Papamaker/kitco/applis/src/spaceinvaders/space-invader-partie.jpg

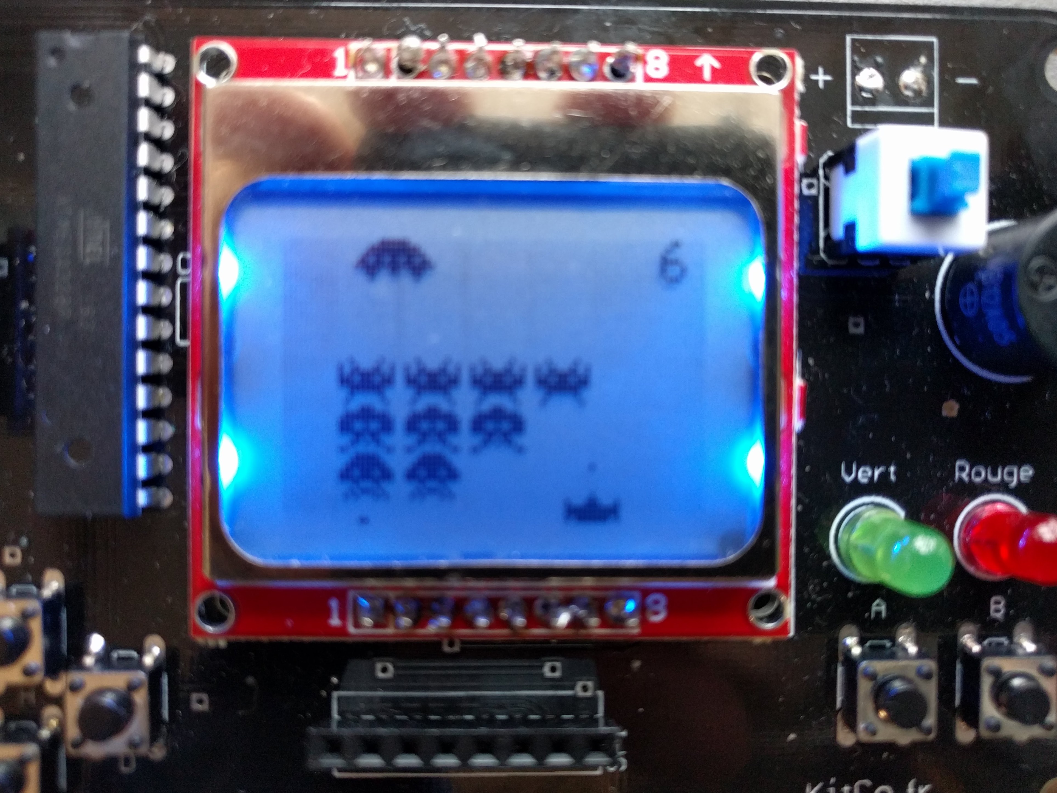
applis/src/spaceinvaders/space-invader-partie.jpg
