Papamaker/kitco/boitiers 3D/laser/IMG_20170427_201355-01.jpeg

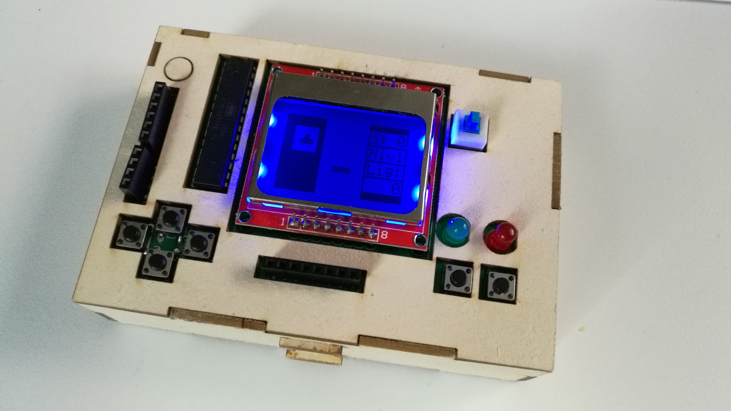
boitiers 3D/laser/IMG_20170427_201355-01.jpeg
