Papamaker/kitco/README.md

# La console Kitco

Auteur: François Jacob

Ceci est le projet de la console Kitco. Le but de ce projet est de fournir un kit de console portable pour un coût réduit en matériel.

Rendez-vous sur www.kitco.fr
