Papamaker/kitco/ManuelKitco.pdf

1

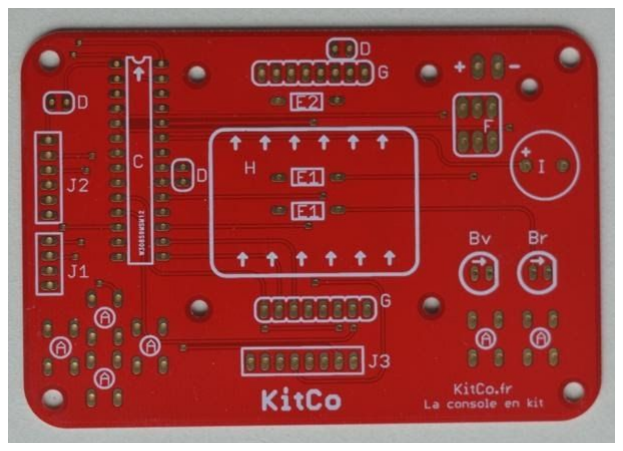
[picture p3: figure]

Circuit imprimé
(PCB : Printed Circuit Board)

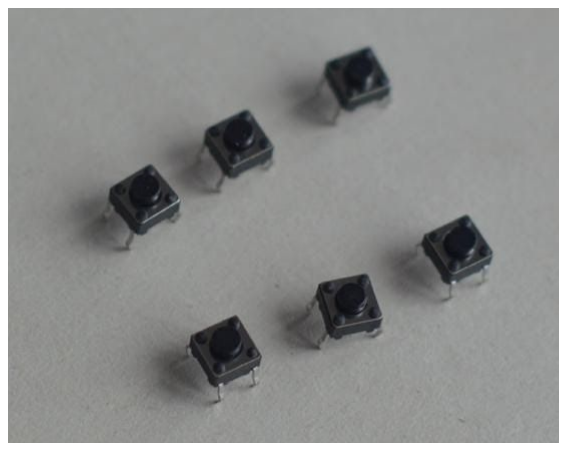
[picture p4: figure]

6 Boutons poussoirs

Positionner (on peut les « clipser ») puis souder les 6 boutons poussoirs sur le circuit imprimé aux endroits marqués « A ».

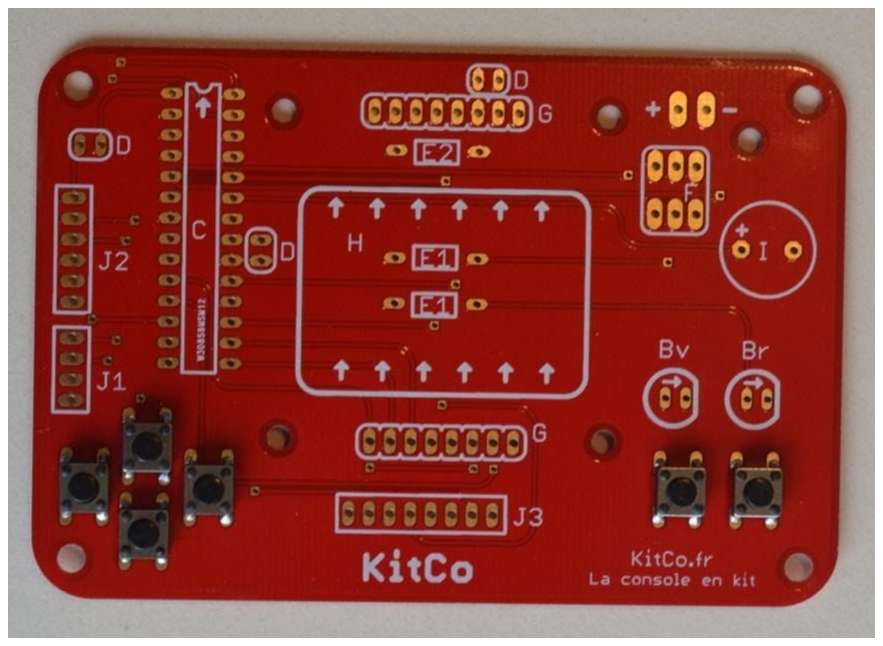
[picture p5: figure]

2

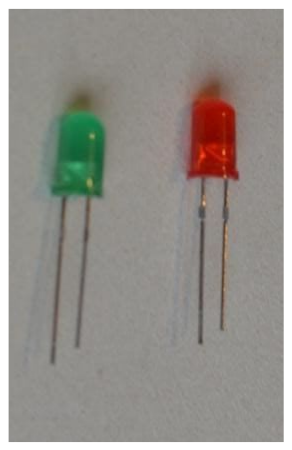
[picture p6: figure]

Diodes électroluminescentes
(LED : Light Emitting Diode)

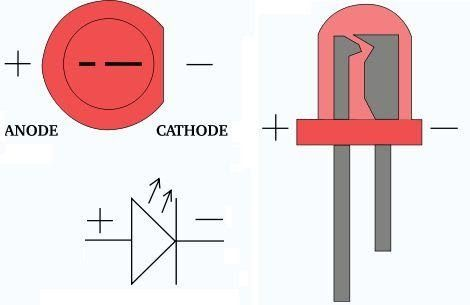
[picture p7: figure]

Positionner les 2 diodes (on peut s’aider de ruban adhésif) puis les souder sur le circuit imprimé aux endroits marqués « Bv » et « Br ».

Respecter la polarité : la patte la plus courte
(et le méplat) vers la droite de la console.

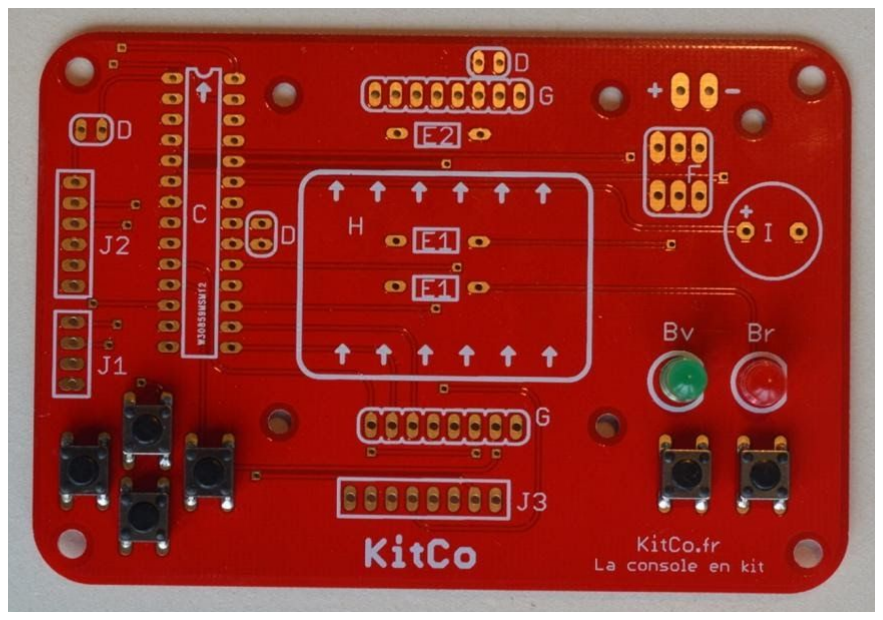
[picture p8: figure]

3

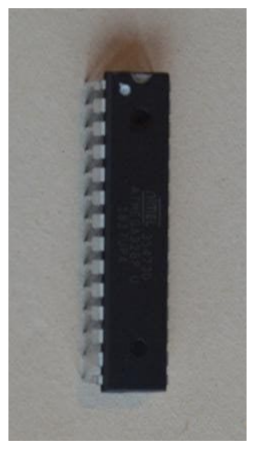
[picture p9: figure]

Microcontrôleur
(Toute « l’intelligence » :
mémoire, mesures, actions)

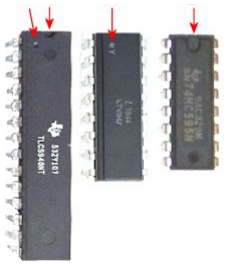
[picture p10: figure]
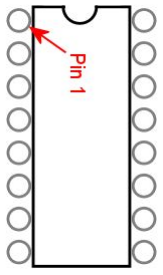
[picture p11: figure]

Souder le microcontrôleur sur le circuit imprimé à l’endroit marqué « C ».

Respecter l’orientation : le méplat vers le haut de la console.

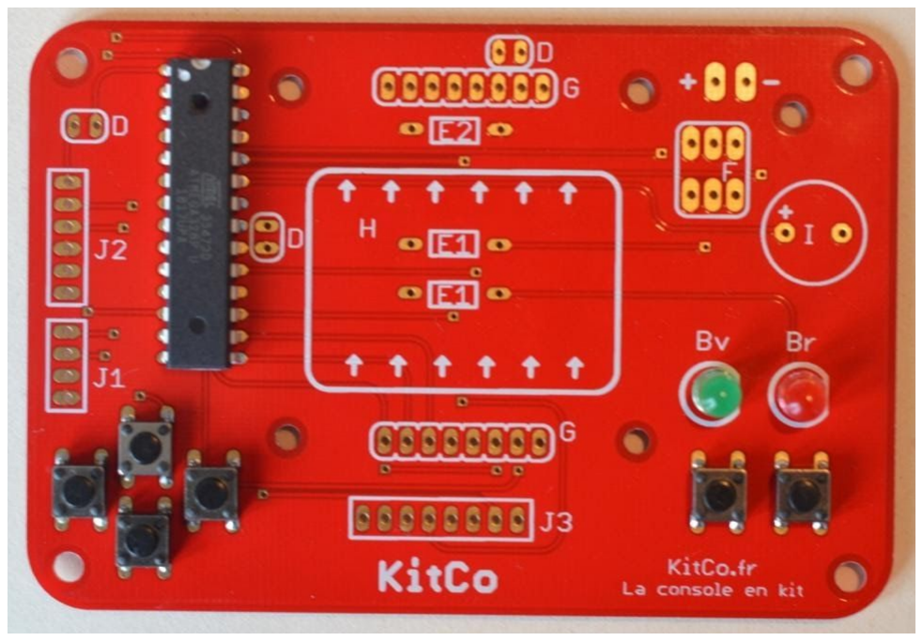
[picture p12: figure]

4

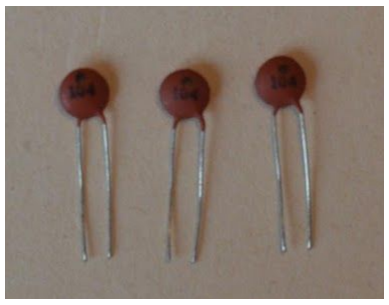
[picture p13: figure]

Condensateurs
(« mini piles rechargeables » : rapide mais peu de capacité)

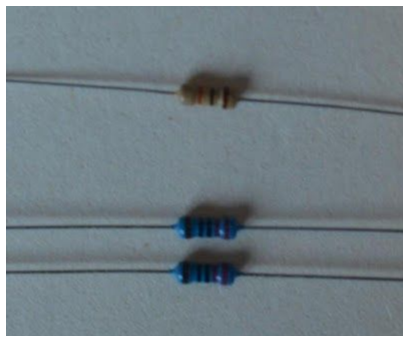
[picture p14: figure]

1 résistance de 10k Ω (Ohm) 2 résistances de 220 Ω
(Pour limiter le courant : afin que la diode ne brûle pas)

Souder les 3 condensateurs (on peut s’aider de ruban adhésif) sur le circuit imprimé aux endroits marqués « D ».
Souder les résistances de 220 Ω | en « E1 ».
Souder la résistance de 10k Ω | en « E2 ».

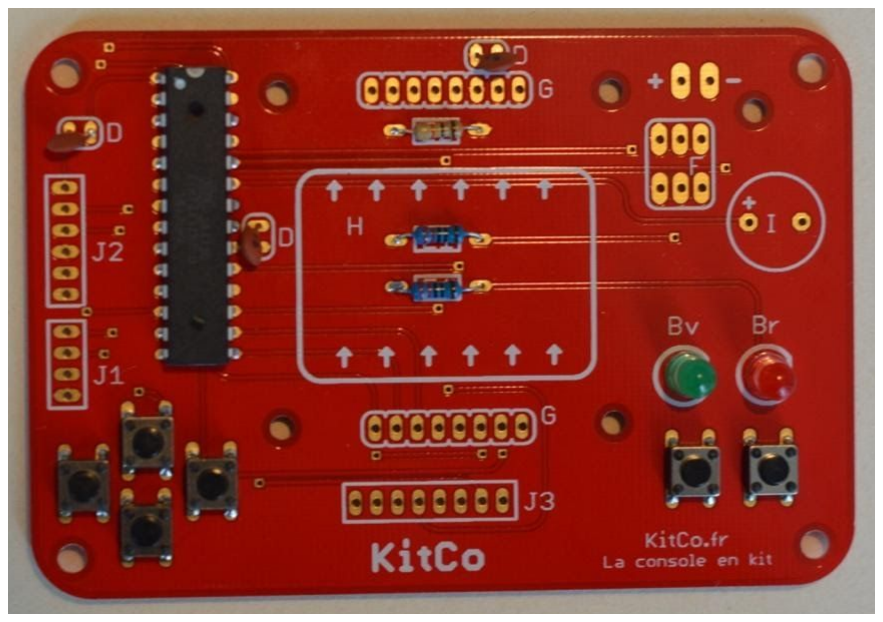
[picture p15: figure]

5

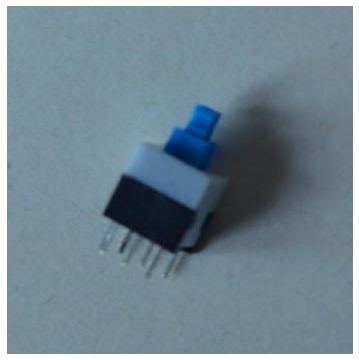
[picture p16: figure]

Interrupteur

Souder l’interrupteur en « F ».

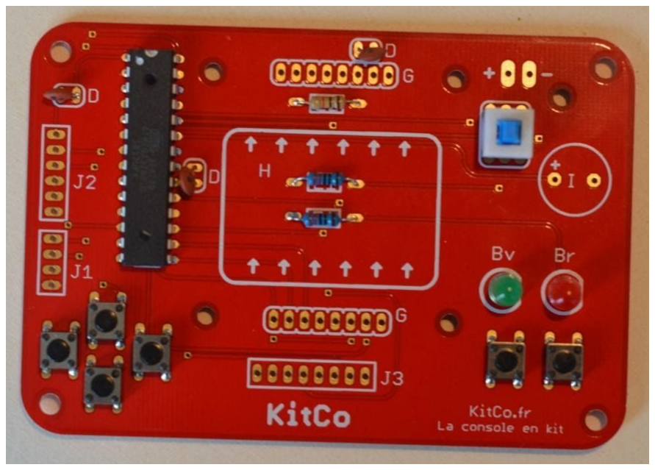
[picture p17: figure]

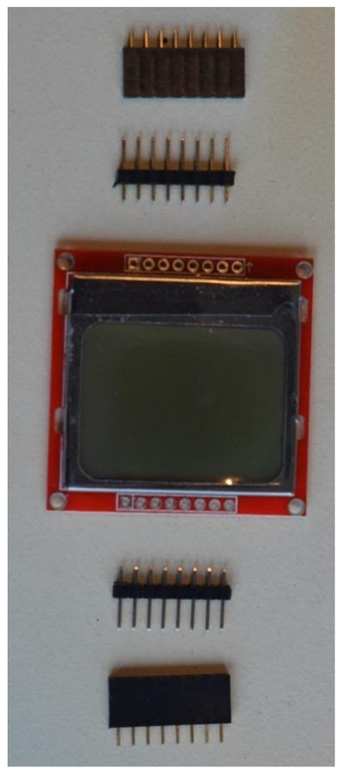
[picture p18: figure]
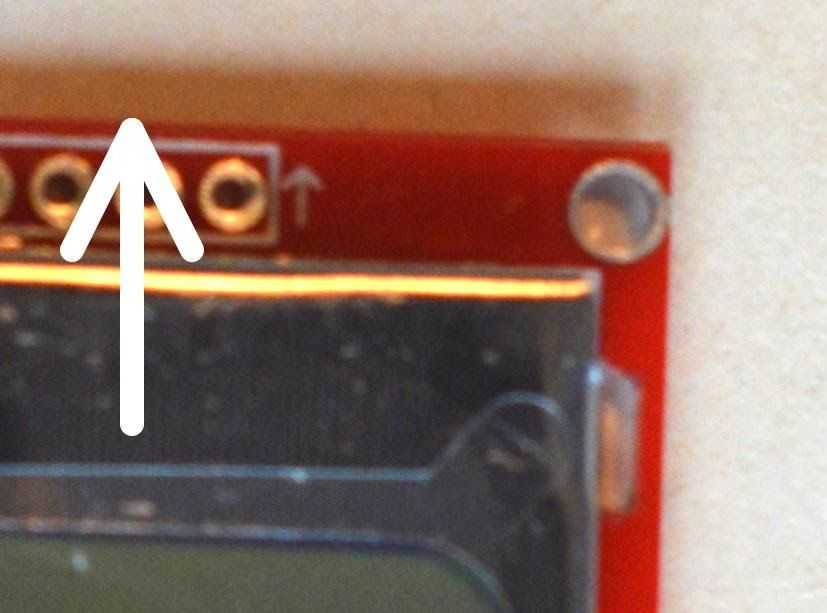
[picture p19: figure]

Assemblage de l’écran
(LCD : Liquid Cristal Display)
6

Assembler 2 paires de connecteurs les insérer en « G », ajouter l’écran. Fixer l’ensemble avec un ruban adhésif avant de souder les deux faces.

Respecter l’orientation : la flèche (et la partie métallique la plus large de l’écran) vers le haut de la console.

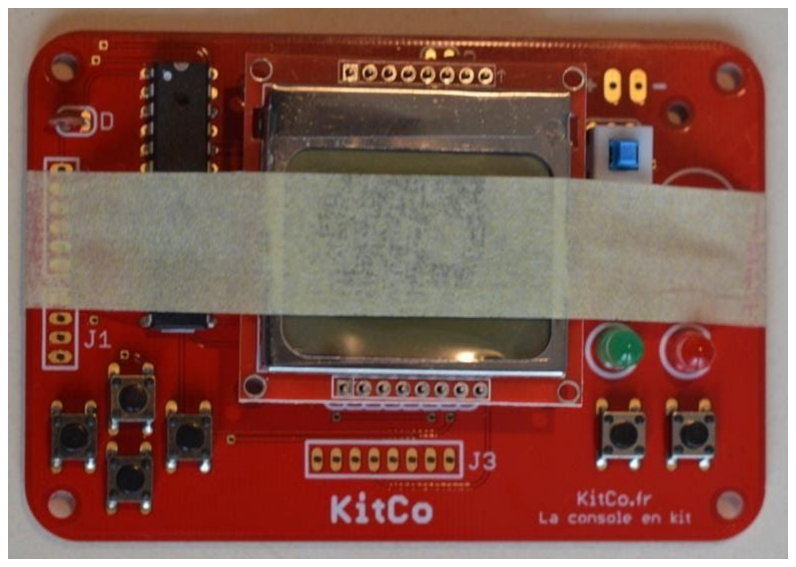
[picture p20: figure]

7

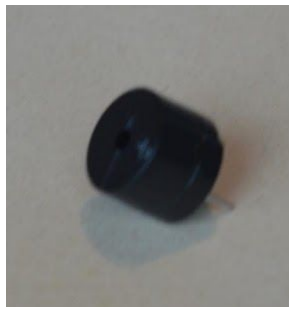
[picture p21: figure]

Buzzer
(Haut-parleur)

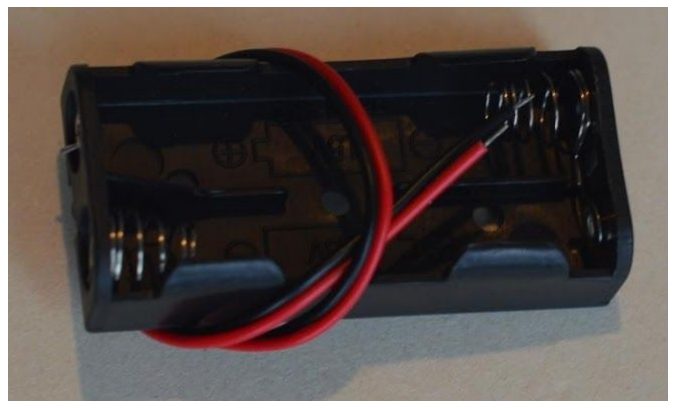
[picture p22: figure]

Boitier piles

Souder le buzzer en « I ».
Respecter la polarité : le « + » vers la gauche de la console.
Passer le câble du boitier piles dans le trou, le nouer puis le souder en « J » (dos de console). Respecter la polarité : le rouge avec le « + », le noir avec le « - ».

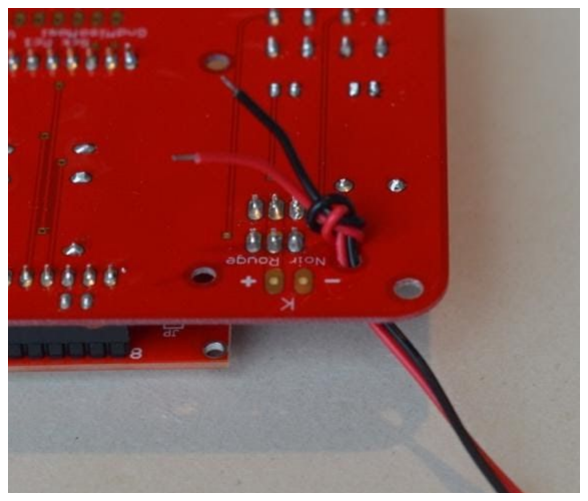
[picture p23: figure]

Il est recommandé de passer le câble dans l’autre sens : nœud sur la face avant de la console.

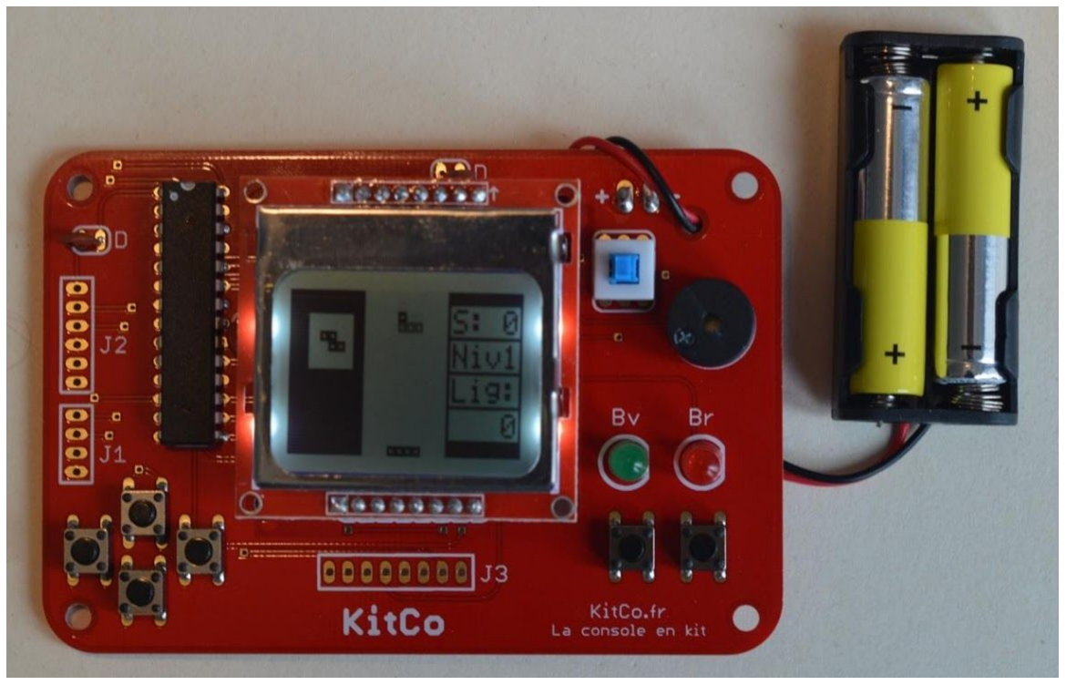
[picture p24: figure]

La KitCo est une console open source conçue pour initier à l’électronique. Les participants pourront en modifier le logiciel après l’atelier à l’aide du logiciel Arduino.
Pour plus d’informations : www.kitco.fr

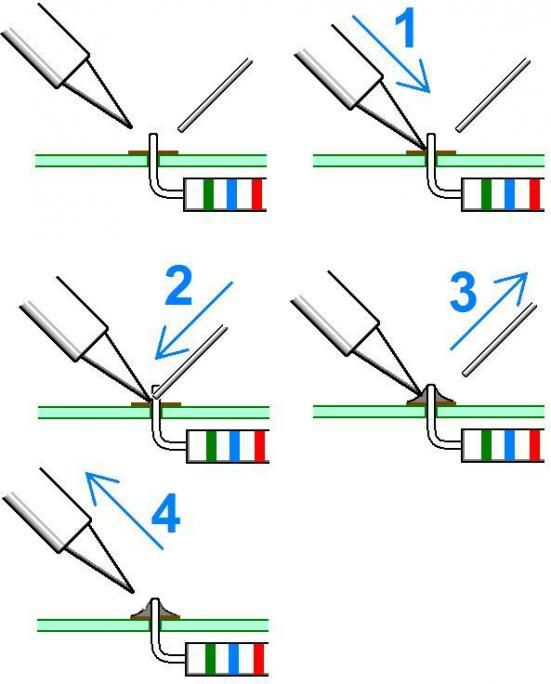
[picture p25: figure]
