Papamaker/kitco/boitiers/carton/readme.md

Version beta: la nouvelle boite n'est pas encore disponible officiellement. Trouvez ici toutes les ressources pour utiliser la nouvelle boite comme boîter pour Kitco!
