Papamaker/kitco/applis/src/readme.md

Les applis suivantes:

- cassebriques
- pacrob 
- snake 

nécessitent les deux librairies adafruit suivantes :
- https://github.com/adafruit/Adafruit-GFX-Library
- https://github.com/adafruit/Adafruit-PCD8544-Nokia-5110-LCD-library
