Papamaker/kitco/applis/src/spaceinvaders/readme.md

Il s'agit d'un jeu codé par Eric Lefevre. Vous pouvez retrouver la dernière version du jeu à cet endroit:

https://github.com/elefevre/jeux-kitco/
