Papamaker/kitco/applis/src/pacrob/README.txt

Ceci est un programme pour apprendre la programmation à des enfants

Le but du jeu est de permettre à pac-rob de sortir du labyrinthe en lui envoyant un programme informatique! 

C'est donc une sorte de pacman mais qui est commandé par un programme au lieu d'être programmé en direct. L'utilisateur spécifie le programme et ensuite le "pac-rob" va éxécuter les instructions et se déplacer en conséquence!

Le but du jeu est de permettre à pac-rob de sortir de différents niveaux intact

Cette application nécessite la bibliothèque adafruit disponible ici:

https://github.com/adafruit/Adafruit-PCD8544-Nokia-5110-LCD-library
