Papamaker/kitco/boitiers/carton/kitco + étiquette.pdf

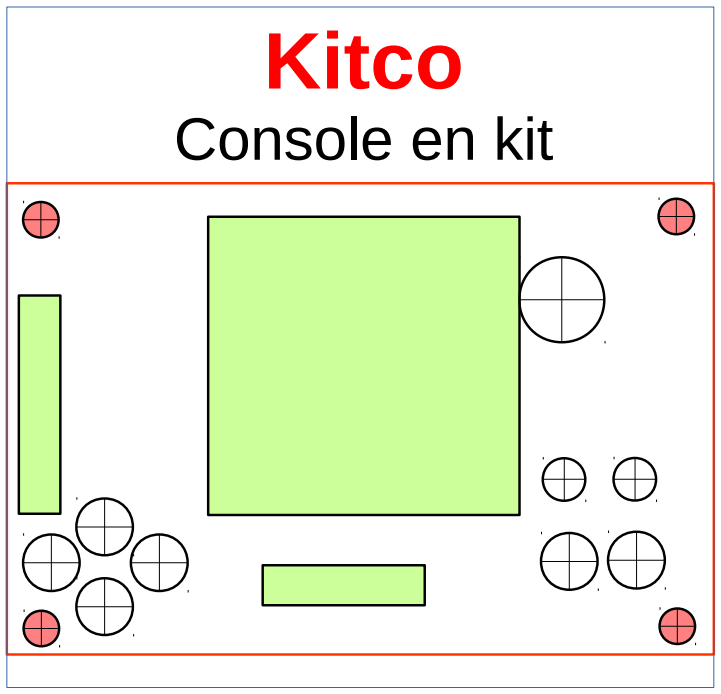
[picture p26: figure]
Kitco Console en kit
