Papamaker/kitco/schemaKitco.png

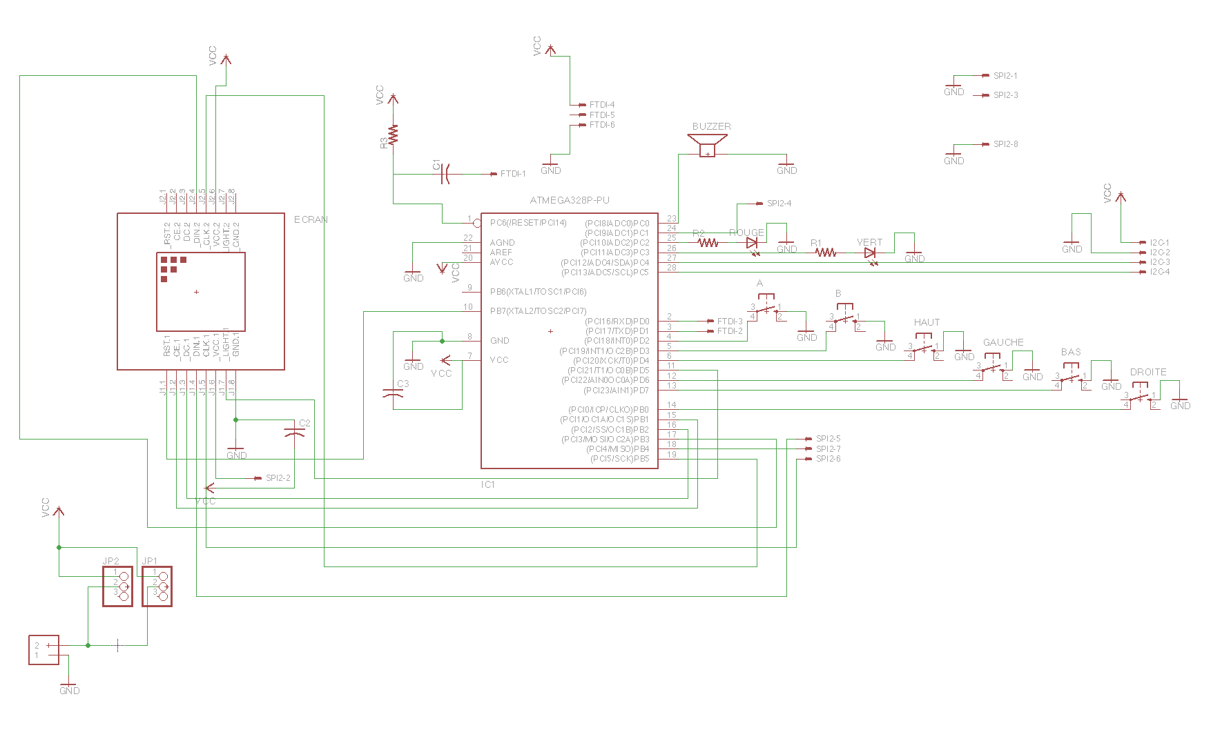
schemaKitco.png
