Papamaker/kitco/boitiers 3D/basic.o/basic_o.stl

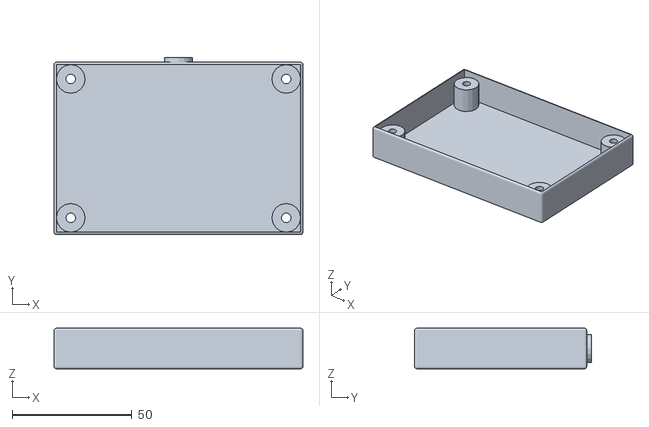
[picture p28: CAD file, 2016-10-02]
boitiers 3D/basic.o/basic_o.stl
104.0 x 74.0 x 17.0
