Papamaker/kitco/boitiers 3D/laser/Kitco01-20170427.stl

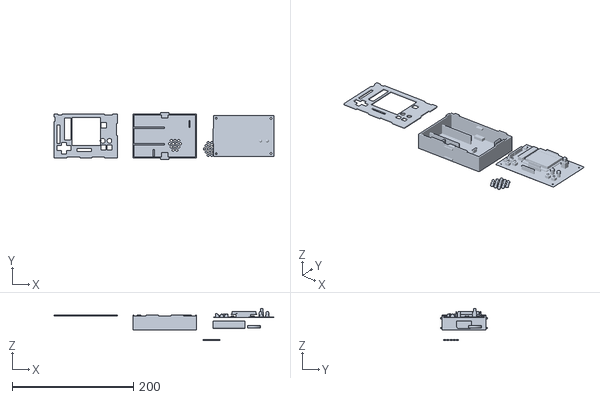
[picture p29: CAD file, 2017-05-20]
boitiers 3D/laser/Kitco01-20170427.stl
362.5 x 77.0 x 53.3
