Papamaker/kitco/(list of files, cad)

Other CAD files:
boitiers 3D/laser/Kitco01-20170427.skp
