Papamaker/kitco/eagle/kitco5.brd

## EAGLE design eagle/kitco5.brd (2017-11-03)

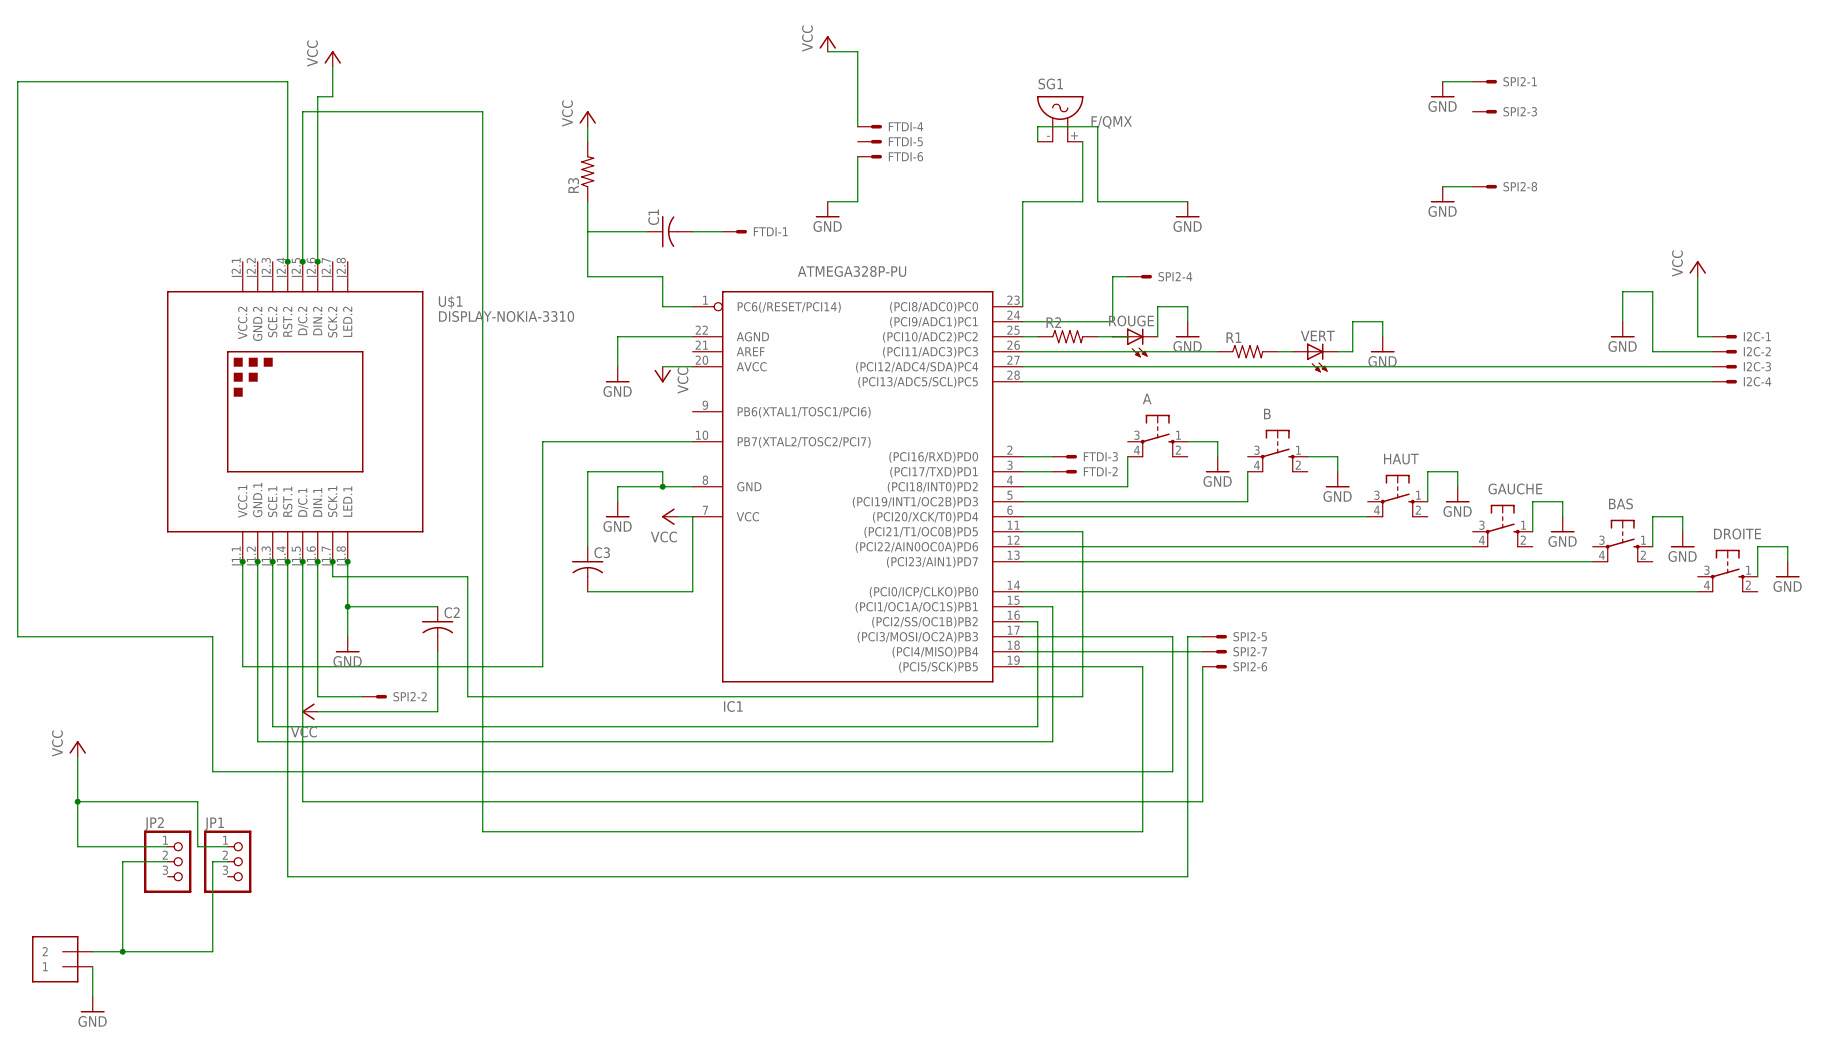
[picture p30: schematic kitco5.sch]

Parts:
A: 10-XX; B3F-10XX
B: 10-XX; B3F-10XX
BAS: 10-XX; B3F-10XX
C1, C2, C3: C-US025-040X050; C025-040X050
DROITE: 10-XX; B3F-10XX
FTDI: 22-23-2061
GAUCHE: 10-XX; B3F-10XX
HAUT: 10-XX; B3F-10XX
I2C: 22-23-2041
IC1: ATMEGA328P-PU; DIL28-3
J1: 1X2-3.5MM
JP1, JP2: PINHD-1X3; 1X03
R1, R2, R3: R-US_0207/10; 0207/10
ROUGE: LED5MM
SG1: F/QMX
SPI2: 22-23-2081
U$1: DISPLAY-NOKIA-3310
VERT: LED5MM

Connections:
GND: A.1 (S), B.1 (S), BAS.1 (S), C2.1, C3.1, DROITE.1 (S), FTDI.6, GAUCHE.1 (S), HAUT.1 (S), I2C.2, IC1.8 (GND), IC1.22 (AGND), J1.1, ROUGE.K (C), SG1.- (1), SPI2.1, SPI2.8, U$1.J1.8 (LED.1), VERT.K (C)
GND.2: U$1.J2.2 (GND.2)
unnamed: A.4 (P1), IC1.4 ((PCI18/INT0)PD2)
unnamed: B.4 (P1), IC1.5 ((PCI19/INT1/OC2B)PD3)
unnamed: IC1.11 ((PCI21/T1/OC0B)PD5), U$1.J1.7 (SCK.1)
unnamed: GAUCHE.4 (P1), IC1.12 ((PCI22/AIN0OC0A)PD6)
unnamed: BAS.4 (P1), IC1.13 ((PCI23/AIN1)PD7)
unnamed: DROITE.4 (P1), IC1.14 ((PCI0/ICP/CLKO)PB0)
unnamed: I2C.3, IC1.27 ((PCI12/ADC4/SDA)PC4)
unnamed: I2C.4, IC1.28 ((PCI13/ADC5/SCL)PC5)
unnamed: J1.2, JP1.2, JP2.2
unnamed: HAUT.4 (P1), IC1.6 ((PCI20/XCK/T0)PD4)
unnamed: FTDI.2, IC1.3 ((PCI17/TXD)PD1)
unnamed: IC1.26 ((PCI11/ADC3)PC3), R1.1
unnamed: R1.2, VERT.A
unnamed: IC1.25 ((PCI10/ADC2)PC2), R2.1
unnamed: R2.2, ROUGE.A
unnamed: IC1.24 ((PCI9/ADC1)PC1), SPI2.4
unnamed: IC1.17 ((PCI3/MOSI/OC2A)PB3), U$1.J2.4 (RST.2)
unnamed: IC1.19 ((PCI5/SCK)PB5), U$1.J2.5 (D/C.2)
unnamed: IC1.15 ((PCI1/OC1A/OC1S)PB1), U$1.J1.2 (GND.1)
unnamed: IC1.16 ((PCI2/SS/OC1B)PB2), U$1.J1.3 (SCE.1)
unnamed: FTDI.3, IC1.2 ((PCI16/RXD)PD0)
unnamed: IC1.18 ((PCI4/MISO)PB4), SPI2.7
unnamed: IC1.23 ((PCI8/ADC0)PC0), SG1.+ (2)
unnamed: SPI2.5, U$1.J1.4 (RST.1)
unnamed: C1.2, FTDI.1
unnamed: SPI2.6, U$1.J1.5 (D/C.1)
unnamed: SPI2.2, U$1.J1.6 (DIN.1)
unnamed: C1.1, IC1.1 (PC6(/RESET/PCI14)), R3.1
unnamed: IC1.10 (PB7(XTAL2/TOSC2/PCI7)), U$1.J1.1 (VCC.1)
VCC: C2.2, C3.2, FTDI.4, I2C.1, IC1.7 (VCC), IC1.20 (AVCC), JP1.1, JP2.1, R3.2, U$1.J2.6 (DIN.2)
VCC.2: U$1.J2.1 (VCC.2)

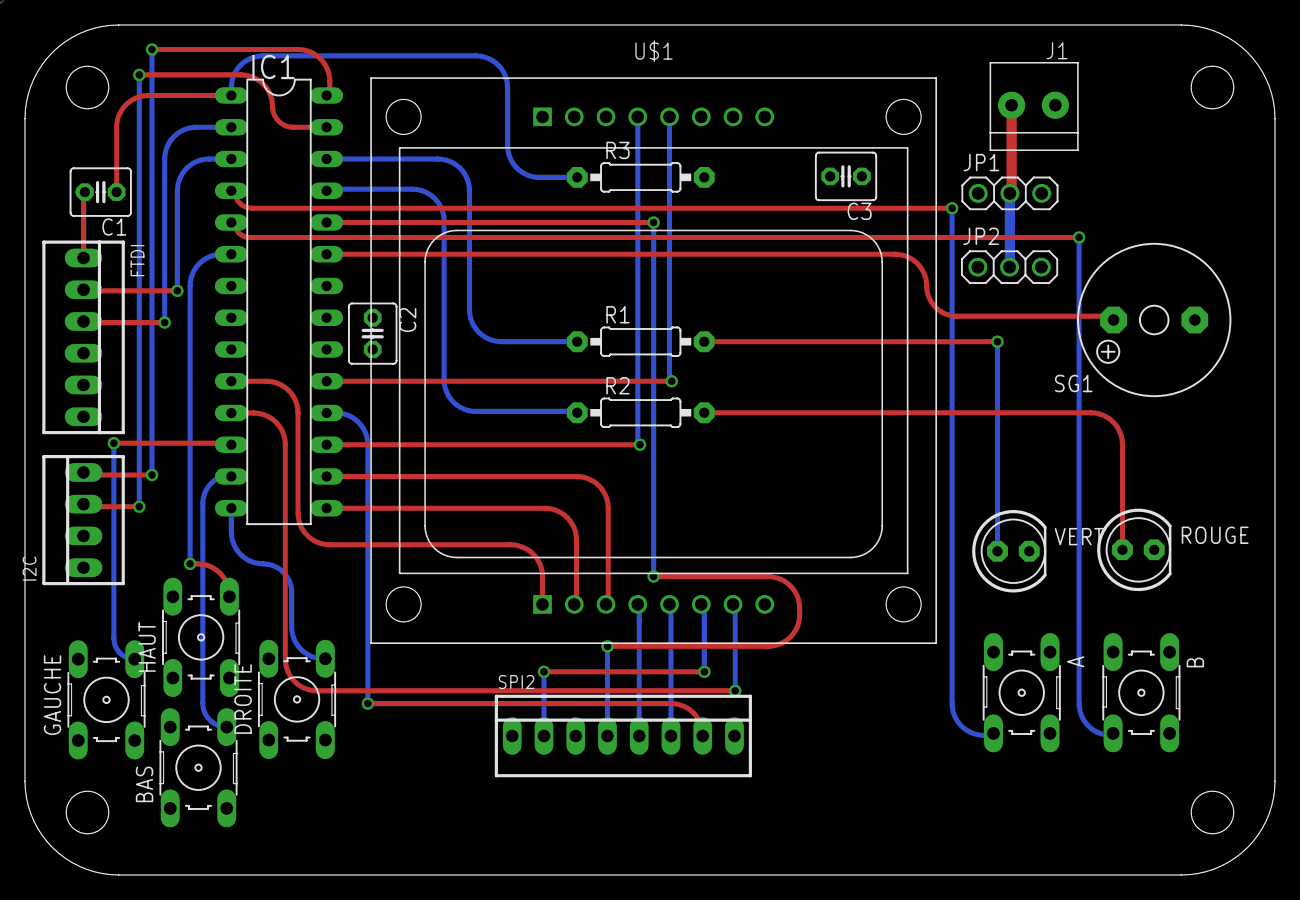
[picture p31: board kitco5.brd from above]

Board: 2 copper layers, 100.0 x 68.0 mm, 23 parts (0 on the bottom side), 31 nets.
