Papamaker/kitco/(commit log)

2016-03-25 mise en place de l'arborescence
    mise en place des répertoire et du premier prog de démo de la
    présentation makerfaire paris à l'école 42
2016-03-28 commit avant de déplacer les fichiers
    commit de l’appli pacrob en cours de dev (je vais la déplacer en local
    chez moi)
2016-03-28 travail du weekend pascal
    sur l’appli pac-rob
2016-04-24 motifs mineurs dans snake
    - ajout de initBoard(1) à appeler dans le setup
    -ajout de litboutons() pour update valeurs touches
    - motif du randomseed
    - ajout de nourriture tout le temps
    - haut et bas inversé…
    - ajout de son et LED rouge quand perdu
    - delay enlevé pour accélérer le jeu (trop lent chez moi)
2016-05-23 Fichiers gerber
    Fichiers gerber proto 0.2
2016-09-11 ajout bootloader
    première version: téléversement et chargement de CFG.HEX depuis le
    bootloader: OK
2016-10-01 travail pour porter les différents jeux sur la kitsch v1
2016-10-02 nouvelle arborescence
    beaucoup plus clean
    [basic.stl, basic_o.stl]
2016-10-02 effacer ancienne arborescence
    [boitier.stl]
2017-01-08 ajout de pong et tetris et mac librairie
2017-01-08 renommage répertoire 1.0 en zip pour ne pas avoir le num de version dans le nom du cep
2017-01-22 bug de synchro
2017-01-22 Revert "bug de synchro"
    This reverts commit 3db693749081f5e34a9b1ed0ed48bc87a60fd485.
2017-01-22 ajout de l'étape 2 du codage de Sokoban
2017-01-25 sokoban3
    ajout de la troisième étape du tutoriel sokoban
2017-02-27 Add files via upload
    This is an other version of the kitco case that I've made.
2017-05-20 proof of concept pour utiliser snap (scratch plus évolué) avec kitco
    [clientKitco.ino, serverKitco.ino]
